mgiambrone/clock4/docs/schematic-notes.md

# Schematic notes (rev 0.2)

The schematic is in `hardware/gpsclock/` (KiCad 7 project), with a PDF export
in `hardware/gpsclock/gpsclock.pdf`. It's generated by
`hardware/tools/gen_schematic.py`, so change the script rather than the
`.kicad_sch` file, or the next run overwrites your edits. If you'd rather edit
in KiCad from now on, just stop using the script.

How the sheet is drawn: every pin has a short wire stub ending in a net label
or a power symbol. Pins with the same label are connected. There are no long
wires to follow.

## Checks done

- KiCad 7 parses the file and exports a netlist: 150 parts, 214 nets.
- A separate check confirmed every pin of DS1–DS5 lands on the right digit/segment net (by pin name from the library).
- `hardware/tools/check_netlist.py` compares KiCad's computed connectivity with
  what the script intended. It flags labels that miss a pin, typo'd nets, nets
  with a single pin, inputs with no driver, two outputs on one net, and parts
  with no footprint (only Q1 is allowed, its part isn't chosen yet). It
  passes. I also broke a copy on purpose (renamed one label, moved another off
  its pin) to make sure it catches mistakes; it flagged both.
- **Not done:** KiCad's own ERC. The `kicad-cli` that was installable here is
  KiCad 7, which has no ERC command, and the KiCad 8 package source was blocked
  by the network. Open the project in KiCad 7/8 and run Inspect → ERC once.

To regenerate and check:

```
python3 hardware/tools/gen_schematic.py
kicad-cli sch export netlist -o /tmp/gpsclock.net hardware/gpsclock/gpsclock.kicad_sch
python3 hardware/tools/check_netlist.py /tmp/gpsclock.net
kicad-cli sch export pdf -o hardware/gpsclock/gpsclock.pdf hardware/gpsclock/gpsclock.kicad_sch
```

## MCU pin map (STM32G030F6P6, TSSOP-20)

All alternate functions were checked against ST's pin database
(STM32_open_pin_data, `STM32G030F6Px.xml`).

| Pin | Port | Function | Net | Notes |
|---|---|---|---|---|
| 1 | PB7 (PB8 bonded) | USART1_RX | DBG_RX | Debug UART. Keep PB8 as an input. |
| 2 | PC14 | RCC_OSC_IN (HSE bypass) | HSE_IN | From the 16 MHz oscillator through R4 (22 Ω). |
| 3 | PC15 | GPIO in (internal pull-up) | BTN_MODE | Mode button SW2 to GND (added in rev 0.2). |
| 4 / 5 | VDD / VSS | | +3V3 / GND | C4 100 nF + C5 4.7 µF. |
| 6 | NRST | | NRST | C6 100 nF, plus the SWD header. |
| 7 | PA0 | ADC1_IN0 | LIGHT | Optional light sensor. |
| 8 | PA1 | GPIO in (internal pull-up) | BTN_BRIGHT | Brightness button SW1 to GND. |
| 9 | PA2 | USART2_TX | GPS_RXD | Only needed if you ever send config commands to the GPS. |
| 10 | PA3 | USART2_RX | GPS_TXD | NMEA at 9600. |
| 11 | PA4 | TIM14_CH1 (PWM) | DISP_OE | Brightness. Active low. R5 pulls it up so the display stays dark during boot. |
| 12 | PA5 | SPI1_SCK | SR_CLK_MCU | → R120 33 Ω → SR_CLK. |
| 13 | PA6 | TIM3_CH1 (input capture) | GPS_PPS | |
| 14 | PA7 | SPI1_MOSI | SR_DATA | |
| 15 | PB0 (PB1, PB2, PA8 bonded) | TIM3_CH3 (output compare) | SR_LATCH_MCU | → R121 33 Ω → SR_LATCH. Same timer as the PPS capture, so the latch edge is hardware-timed against the same counter. **Firmware must leave PB1/PB2/PA8 as inputs.** |
| 16 | PA11 | GPIO out | LED_STATUS | Through R9 (1 k) to D5. |
| 17 | PA12 | GPIO, open-drain | GPS_RESET | R7 pull-up. |
| 18 | PA13 | SWDIO | SWDIO | |
| 19 | PA14 | SWCLK | SWCLK | Shared with BOOT0. G0 option bytes decide whether it acts as BOOT0; check them if the chip ever boots into the ROM bootloader. |
| 20 | PB6 (PB3–PB5 bonded) | USART1_TX | DBG_TX | Keep PB3/PB4/PB5 as inputs. |

Several G030 TSSOP-20 pins are bonded to more than one GPIO (pins 1, 2, 15,
16, 17, 19, 20). Pin 3 (PC15) is not. Only one GPIO per pin may be an output, otherwise they fight.
This is the main firmware gotcha with this package.

## Display (rev 0.2: five dual digits, HH:MM:SS.mmmm)

- **Displays:** five Kingbright DC56-11EWA (0.56", dual digit, common cathode,
  red). These are the 18-pin type: every segment of both digits has its own
  pin, so each digit can still be driven statically. Most generic 2-digit
  displays are 10-pin multiplexed parts and **won't work**. Pin mapping and
  footprint (`Display_7Segment:DA56-11SURKWA`, 2 × 9 pins, rows 15.24 mm
  apart) come from KiCad's library, which follows Kingbright's datasheet.
  That's firmer ground than rev 0.1's generic "5161AS" guess, but still check
  it against the datasheet of the exact variant you buy.
- **Ten digits:** digit 1–2 = hours (DS1), 3–4 = minutes (DS2), 5–6 = seconds
  (DS3), 7–8 = 1/10 and 1/100 s (DS4), 9–10 = 1/1000 and 1/10000 s (DS5). The
  10th digit (0.1 ms) is only meaningful while locked with the oscillator
  measured against PPS. It's the first to blank when precision drops. In other
  modes (Unix time, date, seconds alive) all ten digits are just characters.
- U11–U20 (74HCT595, SOIC-16) drive digits 1–10 in order. Chain: SR_DATA →
  U11 → … → U20; U20's QH' is unused. The byte for digit 10 goes out first.
- SRCLK, RCLK and /OE are common to all ten. /SRCLR is tied to +5V.
- QA–QG → segments A–G, QH → DP, each through its own 470 Ω (R(n·10+k) for
  digit n, segment k: R11–R18 … R101–R108). That's about 5.7–6.4 mA per LED,
  depending on Vf (1.8–2.0 V) and the output drop (0.2–0.3 V). With every
  segment on, that's ≤ ~51 mA per '595, and ~51–58 mA for U12/U14, which drive
  9 LEDs. The package limit is 70 mA.
- **Total current:** all 82 LEDs on is ~0.47–0.52 A from 5 V, plus ~50–100 mA
  on the 3.3 V side. That's under the 750 mA fuse, but above what a PC USB 2.0
  port must supply, so use a ≥ 1 A charger. A normal time display draws less.
  Firmware must run any all-segments self-test at reduced /OE duty (≤ 50%).
- **SR_CLK and SR_LATCH** each drive ten inputs along the display, so they
  get 33 Ω series resistors at the MCU (R120, R121; MCU-side nets
  SR_CLK_MCU/SR_LATCH_MCU). Route each as one daisy-chained trace over solid
  ground. In firmware, use medium or high GPIO speed on PA5/PB0, not "very
  high". SR_DATA only drives U11.
- **Latch rate:** the 0.1 ms digit means latching every 100 µs (10 kHz):
  80 bits per update, ~10 µs of SPI at 8 MHz. Prove this on the breadboard. If
  it's ever a problem, drop that digit to "blank" in firmware; no hardware
  change needed.
- **Colons:** QH of U12 (digit 2's DP output) drives the two LEDs between DS1
  and DS2 (D1, D2 via R28, R29). QH of U14 (digit 4) drives the two between
  DS2 and DS3 (D3, D4 via R48, R49). Those digits' own DP pins are left
  unconnected. Digit 6's DP is the decimal point before the fractions.

## Clock

- Y1 is a 16 MHz 3.3 V CMOS oscillator in a 3225 4-pad package (Abracon ASE
  footprint; most cheap 3225 oscillators share its pinout: 1 EN, 2 GND, 3 OUT,
  4 VDD). Check this against the part you pick.
- Pin 1 is pulled up through R3 (10 k), so EN parts run, NC parts ignore it,
  and the board will also take a CMOS-output TCXO. **Avoid TCXOs whose pin 1
  is VC (voltage control):** R3 would pin VC to the rail.
- R4 (22 Ω) is a series resistor at the oscillator output to soften edges. It
  can be 0 Ω.

## GPS

- U3 ATGM336H-5N31 on the `RF_GPS:ublox_MAX` footprint. The ATGM336H-5N user
  manual (v1.2, section 1) says the module "can directly replace u-blox MAX
  series modules", and its pin table (section 2.4) matches the symbol: GND
  1/10/12, TXD 2, RXD 3, 1PPS 4, ON/OFF 5, VBAT 6, NC 7, VCC 8, nRESET 9, RF_IN
  11, NC 13, VCC_RF 14, reserved 15/18, SDA/SCL 16/17. Copy of the manual:
  https://raw.githubusercontent.com/Edragon/GSM_GPRS_GPS/master/GPS_DOC/ATGM336H-5N%20IC%20datasheet.pdf
- VBAT (pin 6) is tied to VCC. The manual allows 1.5–3.6 V there. There's no
  backup supply, so every power-up is a cold start (decided in the analysis).
  The manual's reference circuit puts a 3 V cell here instead; that's the
  upgrade path.
- ON/OFF (pin 5, active low) is pulled high by R6. The manual's circuit leaves
  it open, so R6 is belt-and-braces. nRESET (manual: "leave floating if
  unused") has a pull-up, R7, and the MCU can pull it low.
- VCC is specified at 3.3 V ±10%, 100 mA. The manual asks for a low-ripple LDO
  (< 50 mVpp), a ground pour under the module, and no fast digital signals
  near it. So keep the SPI chain and /OE PWM traces away from U3 and the RF
  trace.
- **Active antenna feed (checked against manual section 2.7.1):** VCC_RF → L1
  47 nH → RF_IN, with nothing else. The module handles antenna power, open and
  short detection internally (current limited to 50 mA) and reports
  `$GPTXT ... ANTENNA OK/OPEN/SHORT` over the UART. R8 is now 0 Ω; it was 10 Ω
  in rev 0.1, and the pad is kept only as an option. For L1, use an RF-rated
  0603 inductor whose self-resonant frequency is well above 1.6 GHz.
- Optional, not on the schematic: an ultra-low-capacitance RF ESD diode
  (≤ 0.3 pF, e.g. Infineon ESD0P2RF-02LS) from GPS_RF to GND at J2, since the
  antenna cable is handled. The review split on whether it's needed. The
  module is rated 2 kV HBM.
- RF trace from U3 pin 11 to J2: keep it short, 50 Ω coplanar waveguide, with
  ground stitching. That's a layout task.
- TP1 on PPS, TP2 on SR_LATCH: put a scope on both to see the latch-to-PPS
  timing directly.

## Power

- J1 is a 6-pin power-only USB-C receptacle (GCT USB4125 footprint). R1/R2
  5.1 kΩ on CC1/CC2.
- F1 is a 750 mA hold polyfuse (e.g. 1206L075-class), then +5V. It was 500 mA
  in rev 0.1, which sat at the worst-case load.
- U2 AP2112K-3.3 makes +3V3 (MCU, GPS, oscillator; ~40–60 mA). C2 1 µF in,
  C3 10 µF out.
- The '595s and LEDs run straight from +5V. Capacitance on VBUS is kept near
  the USB limit for sinks (10 µF): C1 4.7 µF at the connector, C2 1 µF at the
  LDO, one 10 µF (C21) for the display's /OE PWM load steps, and 100 nF per
  '595 (C11–C20). That's ~16.7 µF nominal, roughly 10 µF after DC-bias
  derating. That's knowingly marginal; it's fine on chargers. A soft-start load
  switch would be the fix if it ever upsets a PC port.
- The 3.3 V side adds C3 10 µF, C5 4.7 µF, C8 10 µF behind the LDO, which
  current-limits their charging.
- No TVS/ESD on VBUS. Optional; add one if the clock will be plugged and
  unplugged a lot.

## Optional parts (fit or leave off)

- Q1 phototransistor + R10 + C10 on PA0 (auto-brightness). Part not chosen yet,
  so it has no footprint.
- D5/R9 status LED and J4 debug UART: cheap and handy for bring-up.
- SW1 (brightness) and SW2 (mode) are needed for mode switching; they're not optional any more.

## Open before PCB layout

1. Check the DC56-11 pinout against the datasheet of the variant you buy (EWA, SRWA, SURKWA…). Its availability isn't confirmed either: Kingbright's single SC56-11 shows as obsolete at DigiKey.
2. ~~Check the ATGM336H active-antenna circuit and pad sizes.~~ Done: the
   circuit and footprint compatibility were confirmed from the manual (see GPS).
   Before layout, still glance at the manual's land-pattern drawing against
   `ublox_MAX`.
3. Pick the oscillator part (and TCXO option) and check its pin 1 function.
4. Pick the phototransistor (or drop it).
5. Run KiCad's ERC once in the GUI.
6. Ideally, check item 1 on a breadboard first, together with the PPS/NMEA
   behaviour: an ATGM336H breakout plus one digit and one 74HCT595.

## Review log

**2026-10-04, multi-agent review of rev 0.1.** Six reviewers covered the MCU,
display, GPS, power, footprint-to-symbol pin matching and timing. Two
independent skeptics then tried to refute each finding. Out of 19 findings, 7
were confirmed by both, 3 split and 9 refuted. Changes made:

- **U2 had no footprint** (generator bug: an empty footprint argument overwrote
  the library default). Fixed in the generator, and `check_netlist.py` now
  fails on any part without a footprint (only Q1 is exempt).
- **5 V current was undercounted** (the DPs and colons were missing). F1 is now
  750 mA, and the figures above are corrected.
- **BOM designators didn't match the schematic.** `bom-draft.md` is now
  generated from the netlist.
- **VBUS capacitance was over the USB sink limit.** Cut from ~32 µF to ~17 µF
  nominal; the residual is documented as accepted.
- **SR_CLK/SR_LATCH fan-out:** added the 33 Ω series resistors R100/R101.
- **Antenna feed** checked against the ATGM336H-5N manual: R8 is now 0 Ω.
  The manual also confirms u-blox MAX drop-in compatibility.
- Split, not acted on: an RF ESD diode on GPS_RF (listed as optional above).
- Refuted, for reference: missing notes on the bonded pins PB9/PA15 (they were
  already covered), SPI NSS on PA4 (software NSS is fine), status LED drive,
  a VBUS drop below 4.5 V (an edge case), PPS re-phasing racing the SPI shift
  (a firmware detail), and NMEA timing needing GPS_RXD (it's already wired).

**2026-10-06, rev 0.2.** Display changed to five Kingbright DC56-11 duals (10
digits, HH:MM:SS.mmmm), with a tenth '595 (U20). Added a mode button SW2 on PC15
(pin 3). Renumbered to make room: the series resistors R100/R101 → R120/R121,
display bulk C20 → C21, and decoupling is now C11–C20. Dropped the generic
single-digit symbol from the custom library. Firmware features are in
`docs/firmware-features.md`.
