mgiambrone/clock4/hardware/gpsclock/gpsclock.pdf

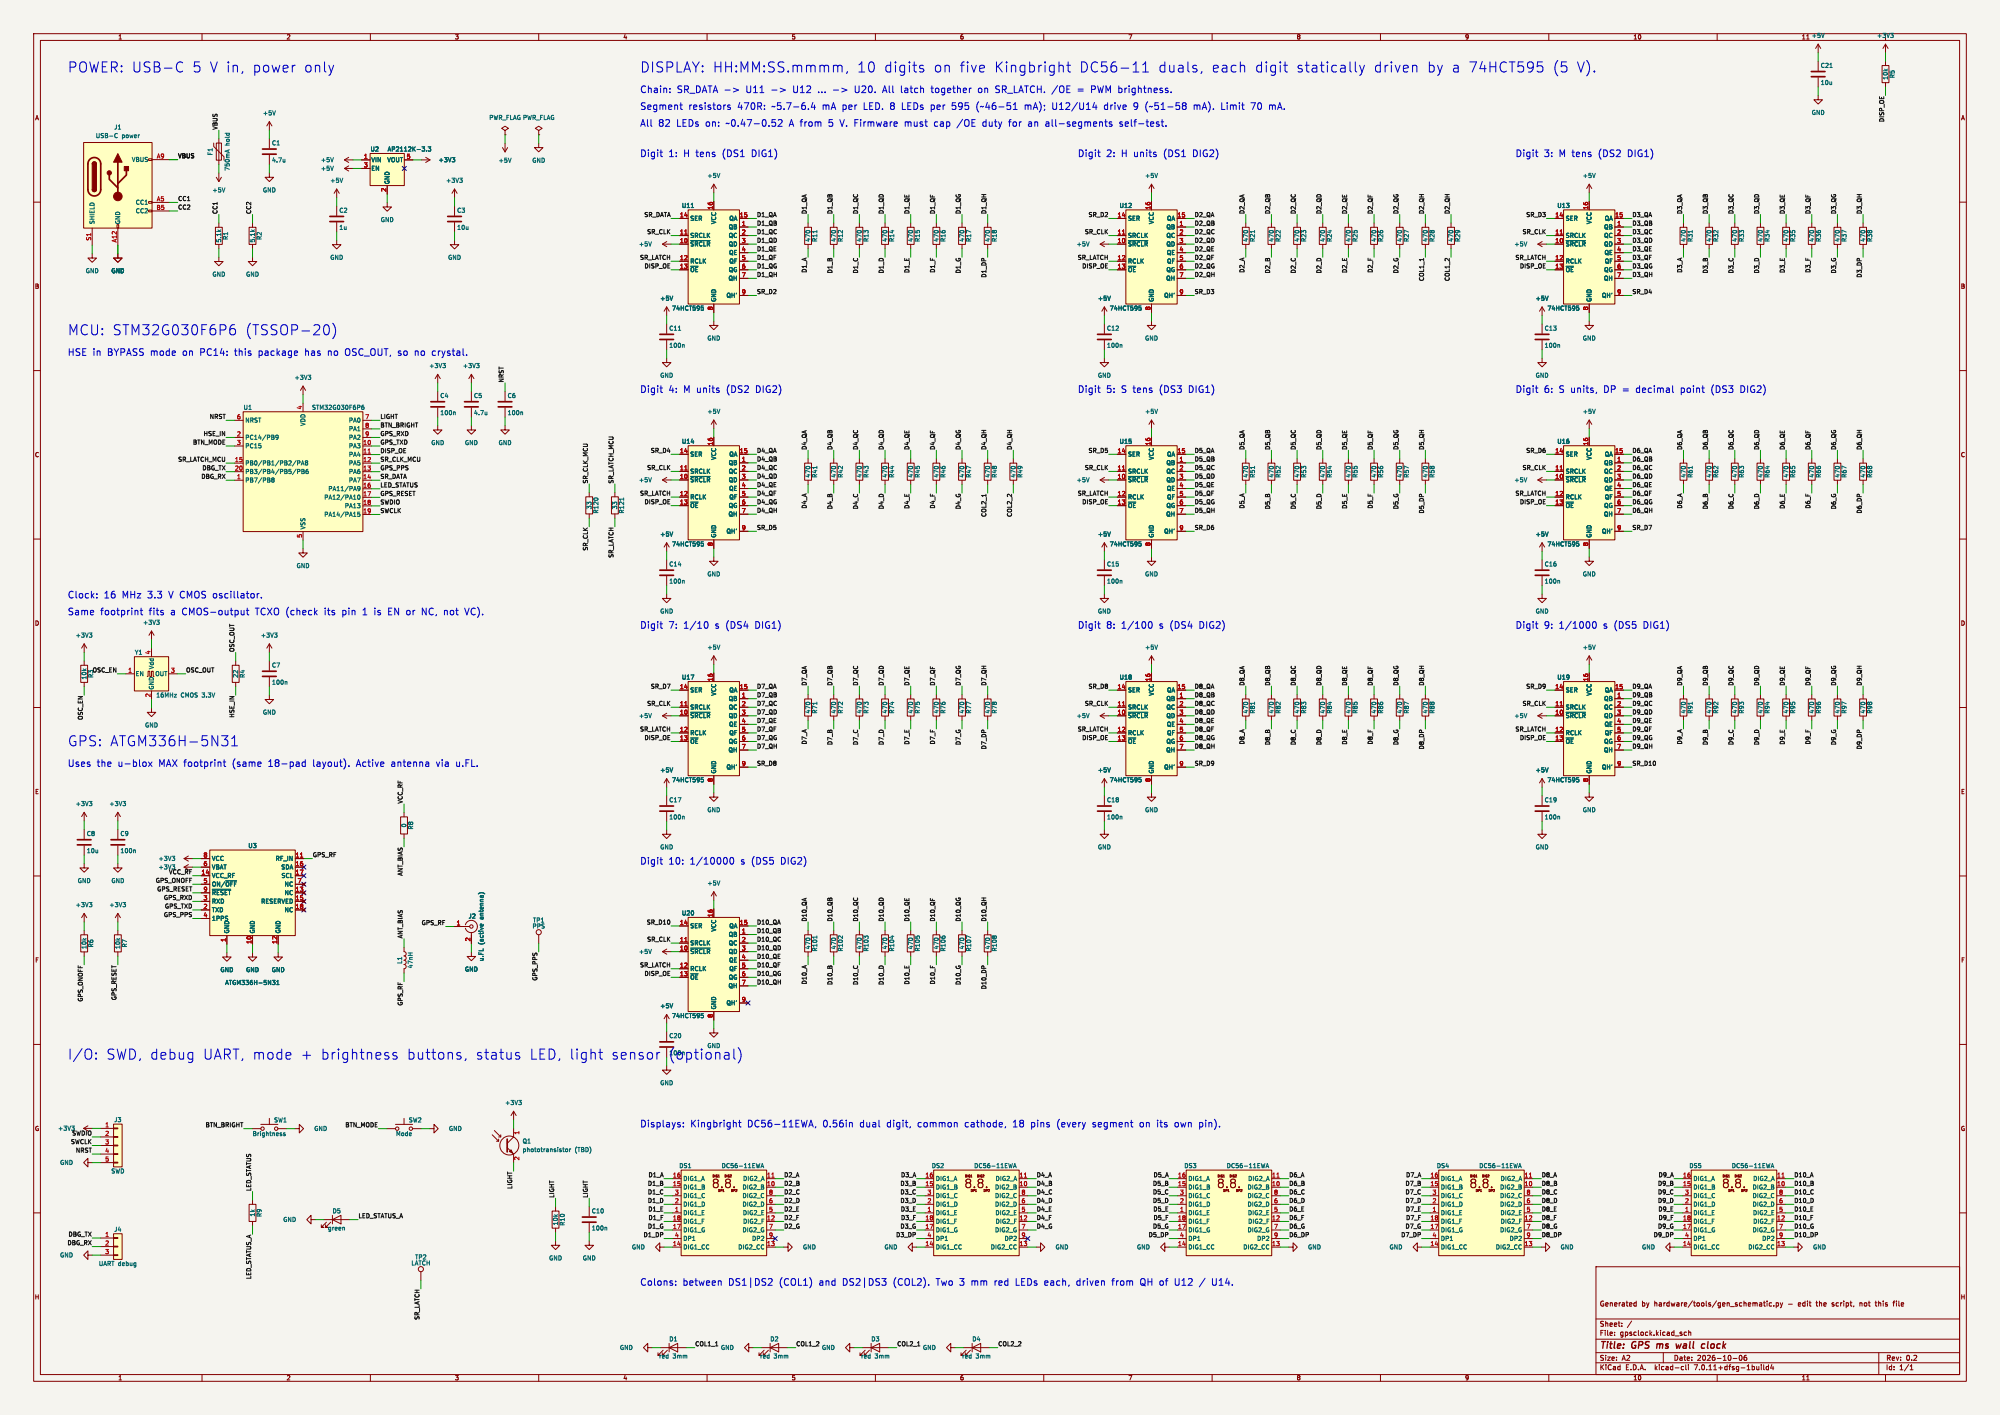
[picture p1: page 1]

POWER: USB-C 5 V in, power only

HSE in BYPASS mode on PC14: this package has no OSC_OUT, so no crystal.

Digit 6: S units, DP = decimal point (DS3 DIG2)
SR_D6 SR_CLK

Clock: 16 MHz 3.3 V CMOS oscillator.

1 GND 10 RF_IN 11 GND 12 NC 13 VCC_RF 14 RESERVED 15 SDA 16 SCL 17 NC 18 TXD 2 RXD 3

J2 u.FL (active antenna) GND

D10_G Colons: between DS1|DS2 (COL1) and DS2|DS3 (COL2). Two 3 mm red LEDs each, driven from QH of U12 / U14.
