mgiambrone/clock4/hardware/gpsclock/gpsclock.kicad_sch

## KiCad design hardware/gpsclock/gpsclock.kicad_sch (2026-10-06)

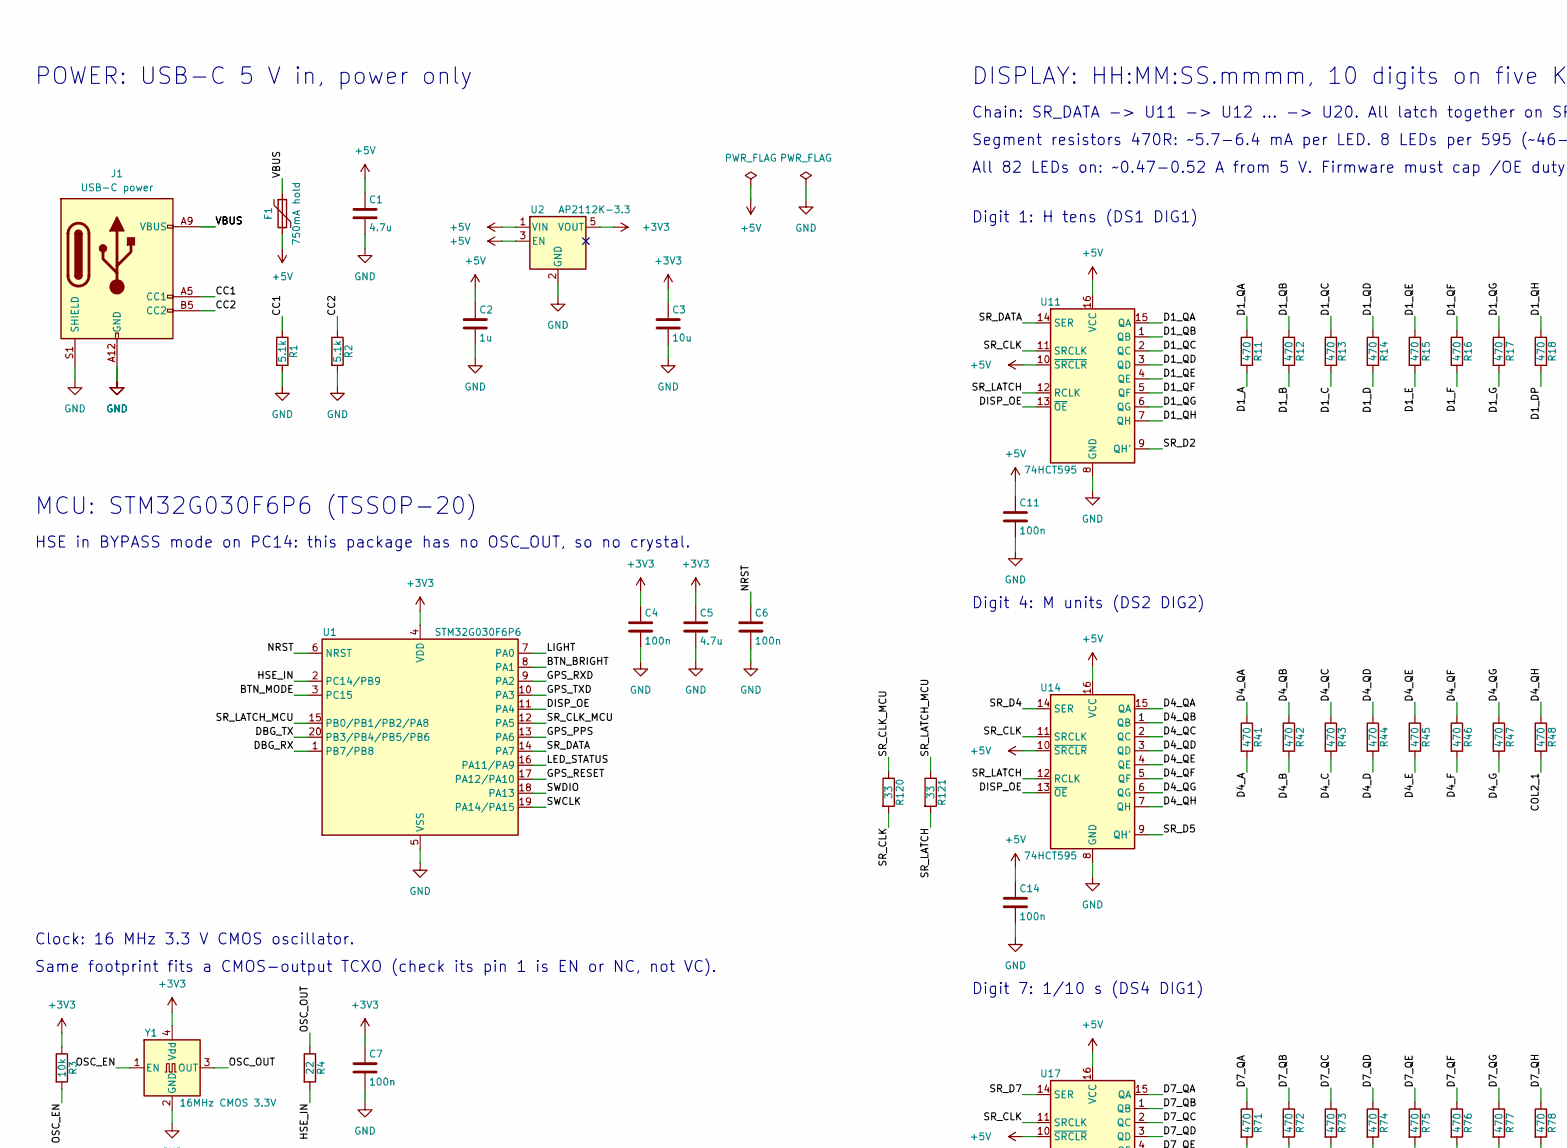
[picture p2: schematic gpsclock.kicad_sch, part in row 1, column 1]

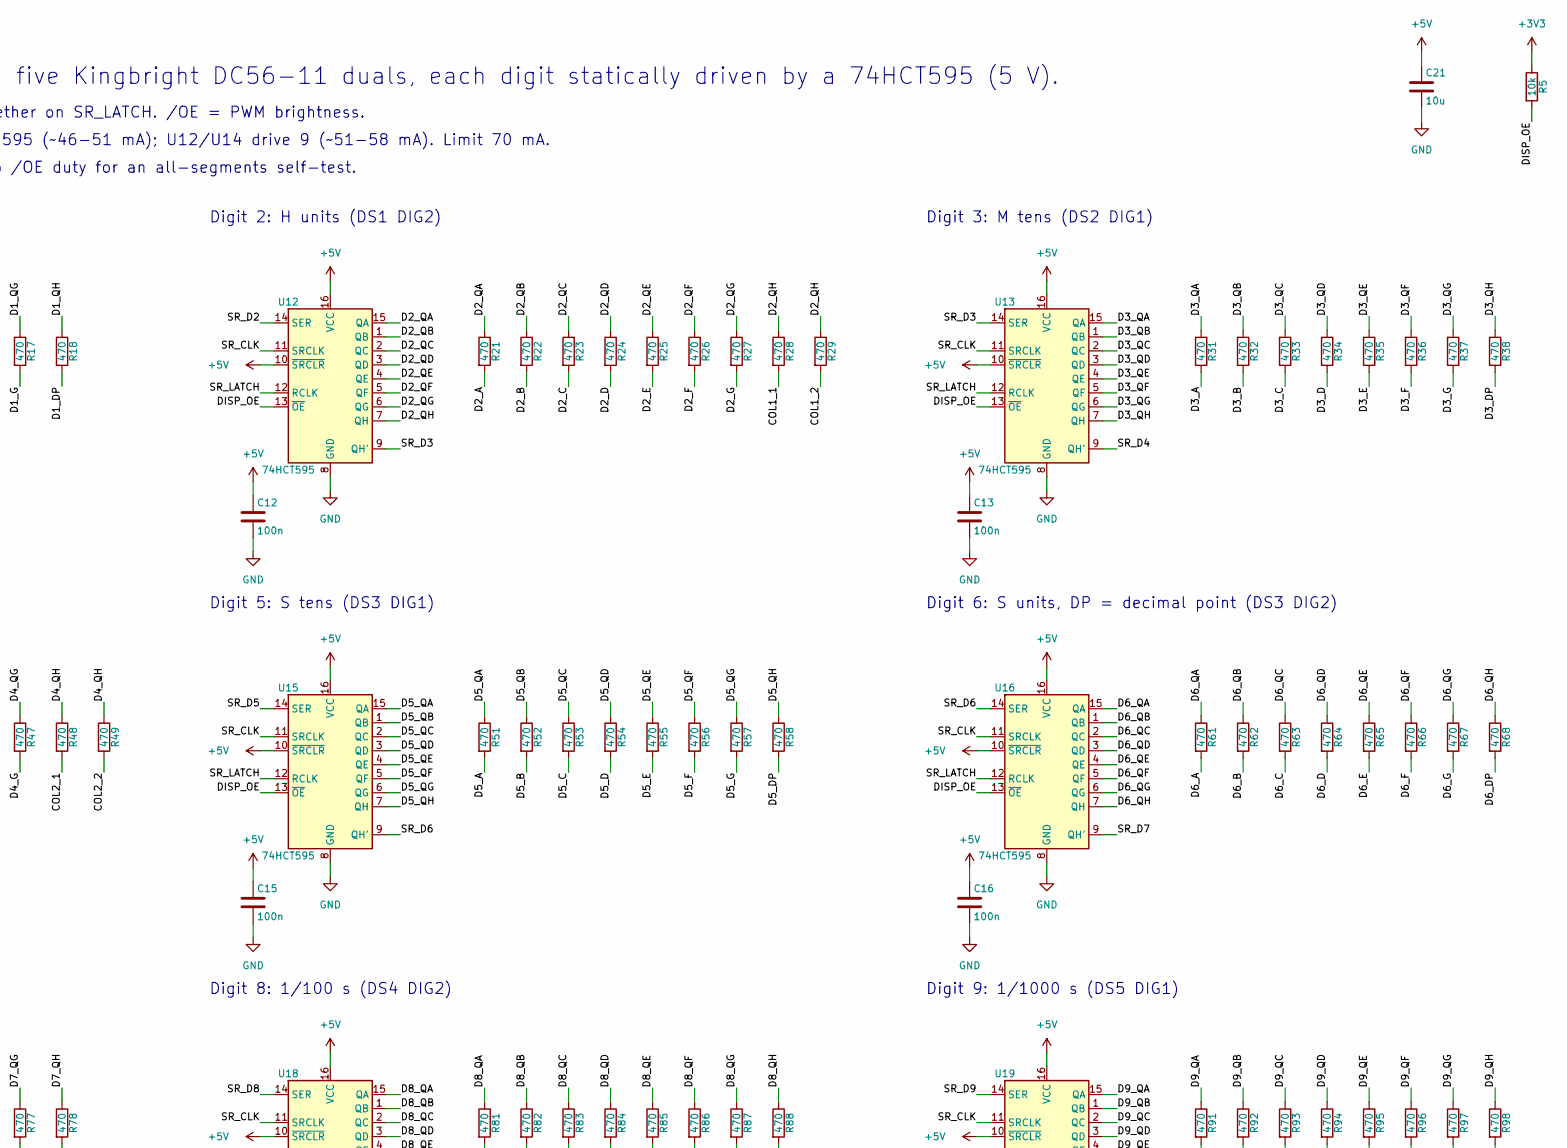
[picture p3: schematic gpsclock.kicad_sch, part in row 1, column 2]

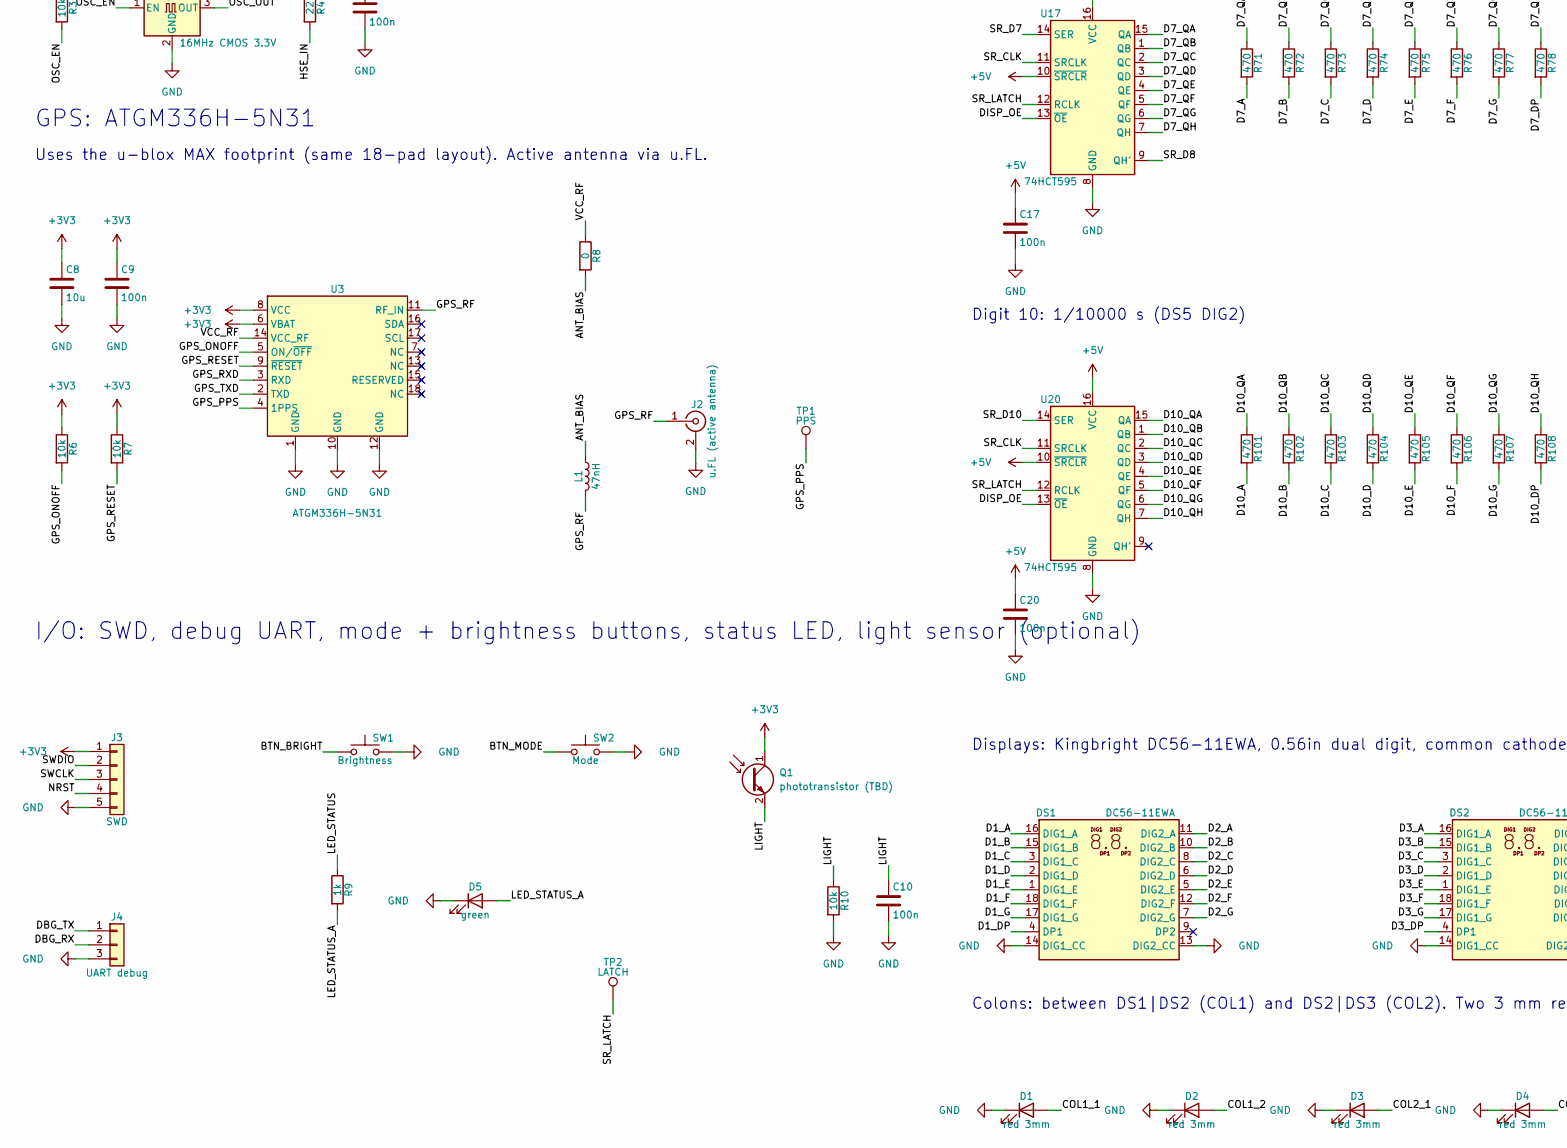
[picture p4: schematic gpsclock.kicad_sch, part in row 2, column 1]

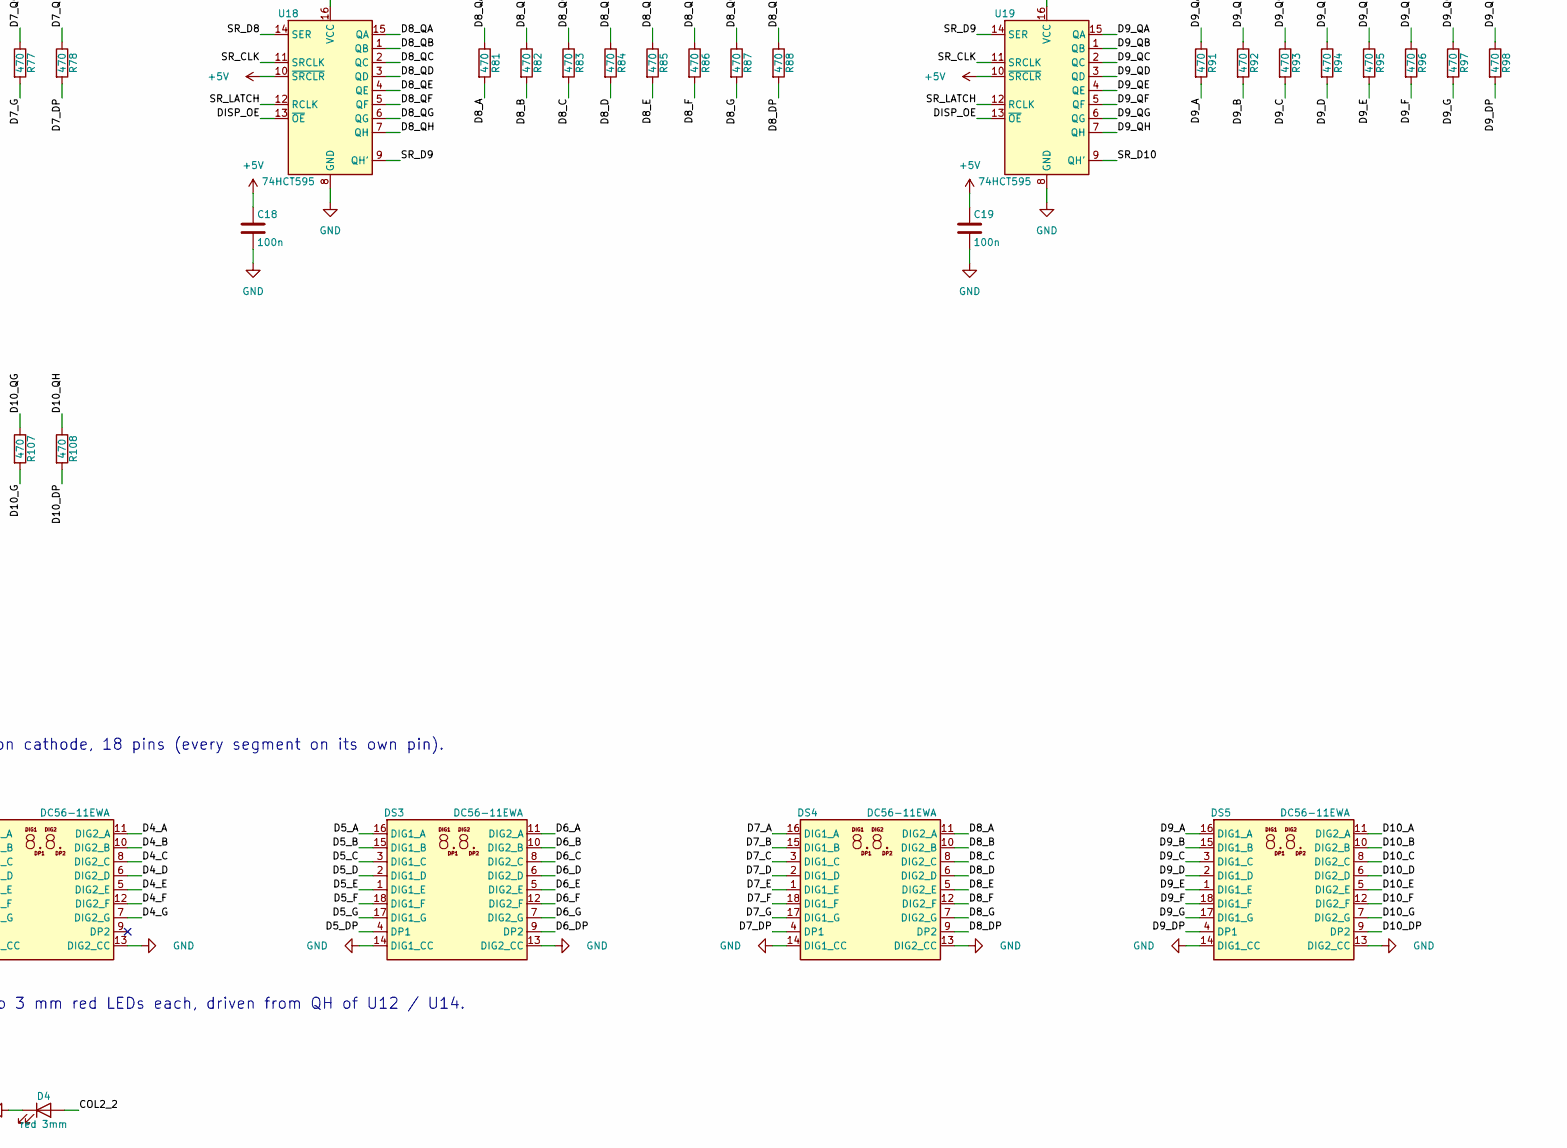
[picture p5: schematic gpsclock.kicad_sch, part in row 2, column 2]

Parts:
C1, C5: 4.7u; C_0805_2012Metric
C2: 1u; C_0603_1608Metric
C3, C8, C21: 10u; C_0805_2012Metric
C4, C6, C7, C9, C10, C11, C12, C13, C14, C15, C16, C17, C18, C19, C20: 100n; C_0603_1608Metric
D1, D2, D3, D4: red 3mm; LED_D3.0mm
D5: green; LED_0603_1608Metric
DS1, DS2, DS3, DS4, DS5: DC56-11EWA; DA56-11SURKWA
F1: 750mA hold; Fuse_1206_3216Metric
J1: USB-C power; USB_C_Receptacle_GCT_USB4125-xx-x_6P_TopMnt_Horizontal
J2: u.FL (active antenna); U.FL_Hirose_U.FL-R-SMT-1_Vertical
J3: SWD; PinHeader_1x05_P2.54mm_Vertical
J4: UART debug; PinHeader_1x03_P2.54mm_Vertical
L1: 47nH; L_0603_1608Metric
Q1: phototransistor (TBD)
R1, R2: 5.1k; R_0603_1608Metric
R3, R5, R6, R7, R10: 10k; R_0603_1608Metric
R4: 22; R_0603_1608Metric
R8: 0; R_0603_1608Metric
R9: 1k; R_0603_1608Metric
R11, R12, R13, R14, R15, R16, R17, R18, R21, R22, R23, R24, R25, R26, R27, R28, R29, R31, R32, R33, R34, R35, R36, R37, R38, R41, R42, R43, R44, R45, R46, R47, R48, R49, R51, R52, R53, R54, R55, R56, R57, R58, R61, R62, R63, R64, R65, R66, R67, R68, R71, R72, R73, R74, R75, R76, R77, R78, R81, R82, R83, R84, R85, R86, R87, R88, R91, R92, R93, R94, R95, R96, R97, R98, R101, R102, R103, R104, R105, R106, R107, R108: 470; R_0603_1608Metric
R120, R121: 33; R_0603_1608Metric
SW1: Brightness; SW_PUSH_6mm
SW2: Mode; SW_PUSH_6mm
TP1: PPS; TestPoint_Pad_D1.0mm
TP2: LATCH; TestPoint_Pad_D1.0mm
U1: STM32G030F6P6; TSSOP-20_4.4x6.5mm_P0.65mm; LCSC C724040
U2: AP2112K-3.3; SOT-23-5
U3: ATGM336H-5N31; ublox_MAX; LCSC C90770
U11, U12, U13, U14, U15, U16, U17, U18, U19, U20: 74HCT595; SOIC-16_3.9x9.9mm_P1.27mm
Y1: 16MHz CMOS 3.3V; Oscillator_SMD_Abracon_ASE-4Pin_3.2x2.5mm

Connections:
+3V3: C3.1, C4.1, C5.1, C7.1, C8.1, C9.1, J3.1, Q1.1 (C), R3.1, R5.1, R6.1, R7.1, U1.4 (VDD), U2.5 (VOUT), U3.6 (VBAT), U3.8 (VCC), Y1.4 (Vdd)
+5V: C1.1, C2.1, C11.1, C12.1, C13.1, C14.1, C15.1, C16.1, C17.1, C18.1, C19.1, C20.1, C21.1, F1.2, U2.1 (VIN), U2.3 (EN), U11.10 (~SRCLR), U11.16 (VCC), U12.10 (~SRCLR), U12.16 (VCC), U13.10 (~SRCLR), U13.16 (VCC), U14.10 (~SRCLR), U14.16 (VCC), U15.10 (~SRCLR), U15.16 (VCC), U16.10 (~SRCLR), U16.16 (VCC), U17.10 (~SRCLR), U17.16 (VCC), U18.10 (~SRCLR), U18.16 (VCC), U19.10 (~SRCLR), U19.16 (VCC), U20.10 (~SRCLR), U20.16 (VCC)
ANT_BIAS: L1.1, R8.2
BTN_BRIGHT: SW1.1, U1.8 (PA1)
BTN_MODE: SW2.1, U1.3 (PC15)
CC1: J1.A5 (CC1), R1.1
CC2: J1.B5 (CC2), R2.1
COL1_1: D1.2 (A), R28.2
COL1_2: D2.2 (A), R29.2
COL2_1: D3.2 (A), R48.2
COL2_2: D4.2 (A), R49.2
D1_A: DS1.16 (DIG1_A), R11.2
D1_B: DS1.15 (DIG1_B), R12.2
D1_C: DS1.3 (DIG1_C), R13.2
D1_D: DS1.2 (DIG1_D), R14.2
D1_DP: DS1.4 (DP1), R18.2
D1_E: DS1.1 (DIG1_E), R15.2
D1_F: DS1.18 (DIG1_F), R16.2
D1_G: DS1.17 (DIG1_G), R17.2
D1_QA: R11.1, U11.15 (QA)
D1_QB: R12.1, U11.1 (QB)
D1_QC: R13.1, U11.2 (QC)
D1_QD: R14.1, U11.3 (QD)
D1_QE: R15.1, U11.4 (QE)
D1_QF: R16.1, U11.5 (QF)
D1_QG: R17.1, U11.6 (QG)
D1_QH: R18.1, U11.7 (QH)
D2_A: DS1.11 (DIG2_A), R21.2
D2_B: DS1.10 (DIG2_B), R22.2
D2_C: DS1.8 (DIG2_C), R23.2
D2_D: DS1.6 (DIG2_D), R24.2
D2_E: DS1.5 (DIG2_E), R25.2
D2_F: DS1.12 (DIG2_F), R26.2
D2_G: DS1.7 (DIG2_G), R27.2
D2_QA: R21.1, U12.15 (QA)
D2_QB: R22.1, U12.1 (QB)
D2_QC: R23.1, U12.2 (QC)
D2_QD: R24.1, U12.3 (QD)
D2_QE: R25.1, U12.4 (QE)
D2_QF: R26.1, U12.5 (QF)
D2_QG: R27.1, U12.6 (QG)
D2_QH: R28.1, R29.1, U12.7 (QH)
D3_A: DS2.16 (DIG1_A), R31.2
D3_B: DS2.15 (DIG1_B), R32.2
D3_C: DS2.3 (DIG1_C), R33.2
D3_D: DS2.2 (DIG1_D), R34.2
D3_DP: DS2.4 (DP1), R38.2
D3_E: DS2.1 (DIG1_E), R35.2
D3_F: DS2.18 (DIG1_F), R36.2
D3_G: DS2.17 (DIG1_G), R37.2
D3_QA: R31.1, U13.15 (QA)
D3_QB: R32.1, U13.1 (QB)
D3_QC: R33.1, U13.2 (QC)
D3_QD: R34.1, U13.3 (QD)
D3_QE: R35.1, U13.4 (QE)
D3_QF: R36.1, U13.5 (QF)
D3_QG: R37.1, U13.6 (QG)
D3_QH: R38.1, U13.7 (QH)
D4_A: DS2.11 (DIG2_A), R41.2
D4_B: DS2.10 (DIG2_B), R42.2
D4_C: DS2.8 (DIG2_C), R43.2
D4_D: DS2.6 (DIG2_D), R44.2
D4_E: DS2.5 (DIG2_E), R45.2
D4_F: DS2.12 (DIG2_F), R46.2
D4_G: DS2.7 (DIG2_G), R47.2
D4_QA: R41.1, U14.15 (QA)
D4_QB: R42.1, U14.1 (QB)
D4_QC: R43.1, U14.2 (QC)
D4_QD: R44.1, U14.3 (QD)
D4_QE: R45.1, U14.4 (QE)
D4_QF: R46.1, U14.5 (QF)
D4_QG: R47.1, U14.6 (QG)
D4_QH: R48.1, R49.1, U14.7 (QH)
D5_A: DS3.16 (DIG1_A), R51.2
D5_B: DS3.15 (DIG1_B), R52.2
D5_C: DS3.3 (DIG1_C), R53.2
D5_D: DS3.2 (DIG1_D), R54.2
D5_DP: DS3.4 (DP1), R58.2
D5_E: DS3.1 (DIG1_E), R55.2
D5_F: DS3.18 (DIG1_F), R56.2
D5_G: DS3.17 (DIG1_G), R57.2
D5_QA: R51.1, U15.15 (QA)
D5_QB: R52.1, U15.1 (QB)
D5_QC: R53.1, U15.2 (QC)
D5_QD: R54.1, U15.3 (QD)
D5_QE: R55.1, U15.4 (QE)
D5_QF: R56.1, U15.5 (QF)
D5_QG: R57.1, U15.6 (QG)
D5_QH: R58.1, U15.7 (QH)
D6_A: DS3.11 (DIG2_A), R61.2
D6_B: DS3.10 (DIG2_B), R62.2
D6_C: DS3.8 (DIG2_C), R63.2
D6_D: DS3.6 (DIG2_D), R64.2
D6_DP: DS3.9 (DP2), R68.2
D6_E: DS3.5 (DIG2_E), R65.2
D6_F: DS3.12 (DIG2_F), R66.2
D6_G: DS3.7 (DIG2_G), R67.2
D6_QA: R61.1, U16.15 (QA)
D6_QB: R62.1, U16.1 (QB)
D6_QC: R63.1, U16.2 (QC)
D6_QD: R64.1, U16.3 (QD)
D6_QE: R65.1, U16.4 (QE)
D6_QF: R66.1, U16.5 (QF)
D6_QG: R67.1, U16.6 (QG)
D6_QH: R68.1, U16.7 (QH)
D7_A: DS4.16 (DIG1_A), R71.2
D7_B: DS4.15 (DIG1_B), R72.2
D7_C: DS4.3 (DIG1_C), R73.2
D7_D: DS4.2 (DIG1_D), R74.2
D7_DP: DS4.4 (DP1), R78.2
D7_E: DS4.1 (DIG1_E), R75.2
D7_F: DS4.18 (DIG1_F), R76.2
D7_G: DS4.17 (DIG1_G), R77.2
D7_QA: R71.1, U17.15 (QA)
D7_QB: R72.1, U17.1 (QB)
D7_QC: R73.1, U17.2 (QC)
D7_QD: R74.1, U17.3 (QD)
D7_QE: R75.1, U17.4 (QE)
D7_QF: R76.1, U17.5 (QF)
D7_QG: R77.1, U17.6 (QG)
D7_QH: R78.1, U17.7 (QH)
D8_A: DS4.11 (DIG2_A), R81.2
D8_B: DS4.10 (DIG2_B), R82.2
D8_C: DS4.8 (DIG2_C), R83.2
D8_D: DS4.6 (DIG2_D), R84.2
D8_DP: DS4.9 (DP2), R88.2
D8_E: DS4.5 (DIG2_E), R85.2
D8_F: DS4.12 (DIG2_F), R86.2
D8_G: DS4.7 (DIG2_G), R87.2
D8_QA: R81.1, U18.15 (QA)
D8_QB: R82.1, U18.1 (QB)
D8_QC: R83.1, U18.2 (QC)
D8_QD: R84.1, U18.3 (QD)
D8_QE: R85.1, U18.4 (QE)
D8_QF: R86.1, U18.5 (QF)
D8_QG: R87.1, U18.6 (QG)
D8_QH: R88.1, U18.7 (QH)
D9_A: DS5.16 (DIG1_A), R91.2
D9_B: DS5.15 (DIG1_B), R92.2
D9_C: DS5.3 (DIG1_C), R93.2
D9_D: DS5.2 (DIG1_D), R94.2
D9_DP: DS5.4 (DP1), R98.2
D9_E: DS5.1 (DIG1_E), R95.2
D9_F: DS5.18 (DIG1_F), R96.2
D9_G: DS5.17 (DIG1_G), R97.2
D9_QA: R91.1, U19.15 (QA)
D9_QB: R92.1, U19.1 (QB)
D9_QC: R93.1, U19.2 (QC)
D9_QD: R94.1, U19.3 (QD)
D9_QE: R95.1, U19.4 (QE)
D9_QF: R96.1, U19.5 (QF)
D9_QG: R97.1, U19.6 (QG)
D9_QH: R98.1, U19.7 (QH)
D10_A: DS5.11 (DIG2_A), R101.2
D10_B: DS5.10 (DIG2_B), R102.2
D10_C: DS5.8 (DIG2_C), R103.2
D10_D: DS5.6 (DIG2_D), R104.2
D10_DP: DS5.9 (DP2), R108.2
D10_E: DS5.5 (DIG2_E), R105.2
D10_F: DS5.12 (DIG2_F), R106.2
D10_G: DS5.7 (DIG2_G), R107.2
D10_QA: R101.1, U20.15 (QA)
D10_QB: R102.1, U20.1 (QB)
D10_QC: R103.1, U20.2 (QC)
D10_QD: R104.1, U20.3 (QD)
D10_QE: R105.1, U20.4 (QE)
D10_QF: R106.1, U20.5 (QF)
D10_QG: R107.1, U20.6 (QG)
D10_QH: R108.1, U20.7 (QH)
DBG_RX: J4.2, U1.1 (PB7/PB8)
DBG_TX: J4.1, U1.20 (PB3/PB4/PB5/PB6)
DISP_OE: R5.2, U1.11 (PA4), U11.13 (~OE), U12.13 (~OE), U13.13 (~OE), U14.13 (~OE), U15.13 (~OE), U16.13 (~OE), U17.13 (~OE), U18.13 (~OE), U19.13 (~OE), U20.13 (~OE)
GND: C1.2, C2.2, C3.2, C4.2, C5.2, C6.2, C7.2, C8.2, C9.2, C10.2, C11.2, C12.2, C13.2, C14.2, C15.2, C16.2, C17.2, C18.2, C19.2, C20.2, C21.2, D1.1 (K), D2.1 (K), D3.1 (K), D4.1 (K), D5.1 (K), DS1.13 (DIG2_CC), DS1.14 (DIG1_CC), DS2.13 (DIG2_CC), DS2.14 (DIG1_CC), DS3.13 (DIG2_CC), DS3.14 (DIG1_CC), DS4.13 (DIG2_CC), DS4.14 (DIG1_CC), DS5.13 (DIG2_CC), DS5.14 (DIG1_CC), J1.A12 (GND), J1.B12 (GND), J1.S1 (SHIELD), J2.2 (Ext), J3.5, J4.3, R1.2, R2.2, R10.2, SW1.2, SW2.2, U1.5 (VSS), U2.2 (GND), U3.1 (GND), U3.10 (GND), U3.12 (GND), U11.8 (GND), U12.8 (GND), U13.8 (GND), U14.8 (GND), U15.8 (GND), U16.8 (GND), U17.8 (GND), U18.8 (GND), U19.8 (GND), U20.8 (GND), Y1.2 (GND)
GPS_ONOFF: R6.2, U3.5 (ON/~OFF)
GPS_PPS: TP1.1, U1.13 (PA6), U3.4 (1PPS)
GPS_RESET: R7.2, U1.17 (PA12/PA10), U3.9 (~RESET)
GPS_RF: J2.1 (In), L1.2, U3.11 (RF_IN)
GPS_RXD: U1.9 (PA2), U3.3 (RXD)
GPS_TXD: U1.10 (PA3), U3.2 (TXD)
HSE_IN: R4.2, U1.2 (PC14/PB9)
LED_STATUS: R9.1, U1.16 (PA11/PA9)
LED_STATUS_A: D5.2 (A), R9.2
LIGHT: C10.1, Q1.2 (E), R10.1, U1.7 (PA0)
NRST: C6.1, J3.4, U1.6 (NRST)
OSC_EN: R3.2, Y1.1 (EN)
OSC_OUT: R4.1, Y1.3 (OUT)
SR_CLK: R120.2, U11.11 (SRCLK), U12.11 (SRCLK), U13.11 (SRCLK), U14.11 (SRCLK), U15.11 (SRCLK), U16.11 (SRCLK), U17.11 (SRCLK), U18.11 (SRCLK), U19.11 (SRCLK), U20.11 (SRCLK)
SR_CLK_MCU: R120.1, U1.12 (PA5)
SR_D2: U11.9 (QH'), U12.14 (SER)
SR_D3: U12.9 (QH'), U13.14 (SER)
SR_D4: U13.9 (QH'), U14.14 (SER)
SR_D5: U14.9 (QH'), U15.14 (SER)
SR_D6: U15.9 (QH'), U16.14 (SER)
SR_D7: U16.9 (QH'), U17.14 (SER)
SR_D8: U17.9 (QH'), U18.14 (SER)
SR_D9: U18.9 (QH'), U19.14 (SER)
SR_D10: U19.9 (QH'), U20.14 (SER)
SR_DATA: U1.14 (PA7), U11.14 (SER)
SR_LATCH: R121.2, TP2.1, U11.12 (RCLK), U12.12 (RCLK), U13.12 (RCLK), U14.12 (RCLK), U15.12 (RCLK), U16.12 (RCLK), U17.12 (RCLK), U18.12 (RCLK), U19.12 (RCLK), U20.12 (RCLK)
SR_LATCH_MCU: R121.1, U1.15 (PB0/PB1/PB2/PA8)
SWCLK: J3.3, U1.19 (PA14/PA15)
SWDIO: J3.2, U1.18 (PA13)
VBUS: F1.1, J1.A9 (VBUS), J1.B9 (VBUS)
VCC_RF: R8.1, U3.14 (VCC_RF)

Notes on the sheet:
POWER: USB-C 5 V in, power only
MCU: STM32G030F6P6 (TSSOP-20)
HSE in BYPASS mode on PC14: this package has no OSC_OUT, so no crystal.
Clock: 16 MHz 3.3 V CMOS oscillator.
Same footprint fits a CMOS-output TCXO (check its pin 1 is EN or NC, not VC).
GPS: ATGM336H-5N31
Uses the u-blox MAX footprint (same 18-pad layout). Active antenna via u.FL.
I/O: SWD, debug UART, mode + brightness buttons, status LED, light sensor (optional)
DISPLAY: HH:MM:SS.mmmm, 10 digits on five Kingbright DC56-11 duals, each digit statically driven by a 74HCT595 (5 V).
Chain: SR_DATA -> U11 -> U12 ... -> U20. All latch together on SR_LATCH. /OE = PWM brightness.
Segment resistors 470R: ~5.7-6.4 mA per LED. 8 LEDs per 595 (~46-51 mA); U12/U14 drive 9 (~51-58 mA). Limit 70 mA.
All 82 LEDs on: ~0.47-0.52 A from 5 V. Firmware must cap /OE duty for an all-segments self-test.
Digit 1: H tens (DS1 DIG1)
Digit 2: H units (DS1 DIG2)
Digit 3: M tens (DS2 DIG1)
Digit 4: M units (DS2 DIG2)
Digit 5: S tens (DS3 DIG1)
Digit 6: S units, DP = decimal point (DS3 DIG2)
Digit 7: 1/10 s (DS4 DIG1)
Digit 8: 1/100 s (DS4 DIG2)
Digit 9: 1/1000 s (DS5 DIG1)
Digit 10: 1/10000 s (DS5 DIG2)
Displays: Kingbright DC56-11EWA, 0.56in dual digit, common cathode, 18 pins (every segment on its own pin).
Colons: between DS1|DS2 (COL1) and DS2|DS3 (COL2). Two 3 mm red LEDs each, driven from QH of U12 / U14.
