mgiambrone/clock4/(commit log)

2026-10-04 Add analysis and draft BOM for a cheap GPS ms wall clock
    Study of the Mk IV firmware (PPS handling, display, tolerance logic),
    license/hardware-file findings, keep/cut list, and a proposed
    STM32G030 + ATGM336H + 74HCT595 static-drive design with a rough BOM.
    reference/ (local clone of upstream) is git-ignored.
    Claude-Session: https://claude.ai/code/session_01XvyGkgyfnJ274YR57krtzr
2026-10-04 Start schematic: KiCad 7 project generated from a script
    hardware/tools/gen_schematic.py writes hardware/gpsclock/gpsclock.kicad_sch
    (STM32G030F6, ATGM336H, 9x 74HCT595 + 0.56in digits, USB-C power).
    check_netlist.py verifies KiCad's netlist against the intended connections,
    since kicad-cli 7 has no ERC. Notes and open items in docs/schematic-notes.md.
    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
    [gpsclock.kicad_sch]
2026-10-04 Apply schematic review fixes
    Multi-agent review of rev 0.1 (19 findings, 7 confirmed):
    - U2 regulator had no footprint: generator now falls back to the library
    default, and check_netlist.py fails on parts without a footprint
    - F1 750 mA hold; correct the 5 V current figures (74 LEDs, not 72)
    - 33R series resistors R100/R101 on SR_CLK and SR_LATCH
    - Cut VBUS bulk capacitance toward the USB 10 uF sink limit
    - Antenna feed per ATGM336H-5N manual 2.7.1: R8 now 0R
    - BOM reference designators regenerated from the netlist
    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
    [gpsclock.kicad_sch]
2026-10-04 Add shopping list for breadboard and PCB stages
    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
2026-10-06 Rev 0.2: five DC56-11 duals (HH:MM:SS.mmmm), mode button, firmware plan
    - Display: ten digits on five Kingbright DC56-11 18-pin duals, tenth
    74HCT595 (U20); pin mapping from the KiCad library symbol
    - SW2 mode button on PC15; refs renumbered (R120/R121, C21, C11-C20)
    - docs/firmware-features.md: modes, seconds-alive epoch with leap
    seconds, buttons, settings
    - BOM and shopping lists updated for the duals (~$2.13-3.65 each)
    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
    [gpsclock.kicad_sch]
2026-10-06 Add checked breadboard layout for the 4-digit test build
    breadboard_gen.py places two DC56-11 duals, four 74HCT595s, the G030 on a
    TSSOP adapter, GPS breakout, LDO and buttons on two breadboards, verifies
    hole usage and strip connectivity against the intended netlist, and
    renders an interactive page with build order and wiring list.
    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
